bigMOTOR/prusa-remote-display/assets/images/display-social.png

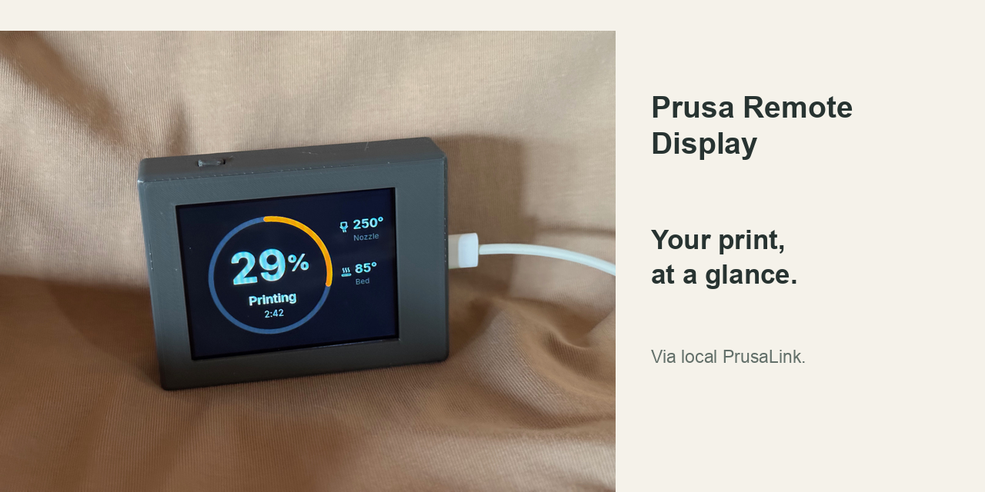
assets/images/display-social.png
