bigMOTOR/prusa-remote-display/enclosure/3mf/display-enclosure.3mf

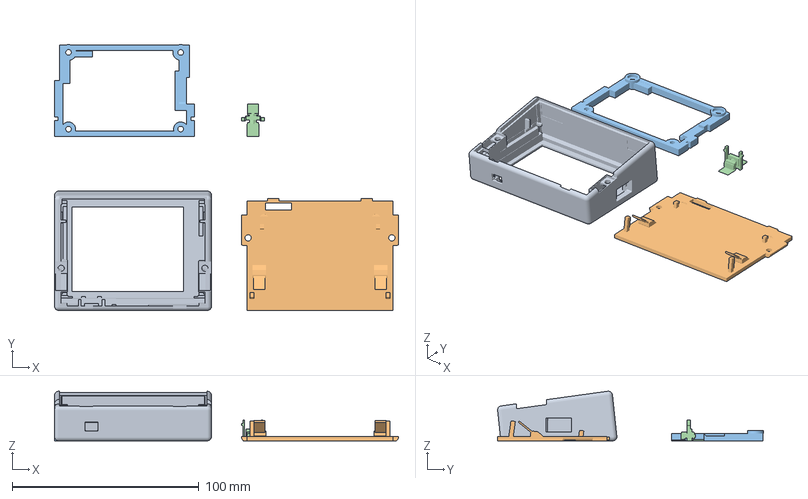
[picture p7: CAD file, 2026-11-03]
enclosure/3mf/display-enclosure.3mf
184.0 x 142.2 x 26.6 mm
