bigMOTOR/prusa-remote-display/enclosure/source/bases/button.step

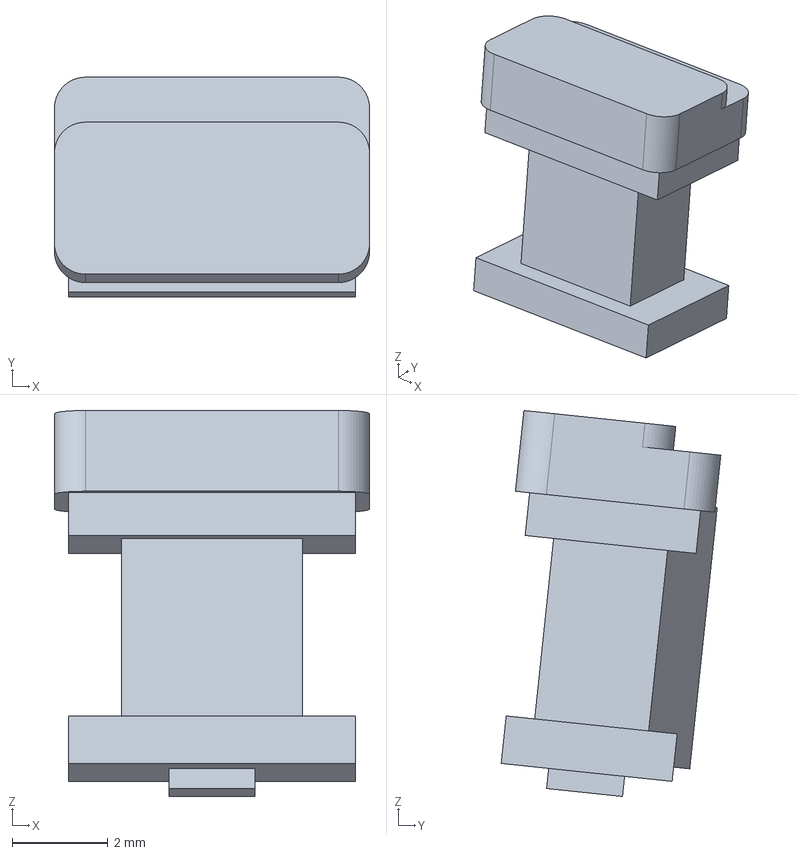
[picture p8: CAD file, 2026-11-03]
enclosure/source/bases/button.step
6.60 x 4.60 x 8.08 mm
