bigMOTOR/prusa-remote-display/enclosure/step/carrier.step

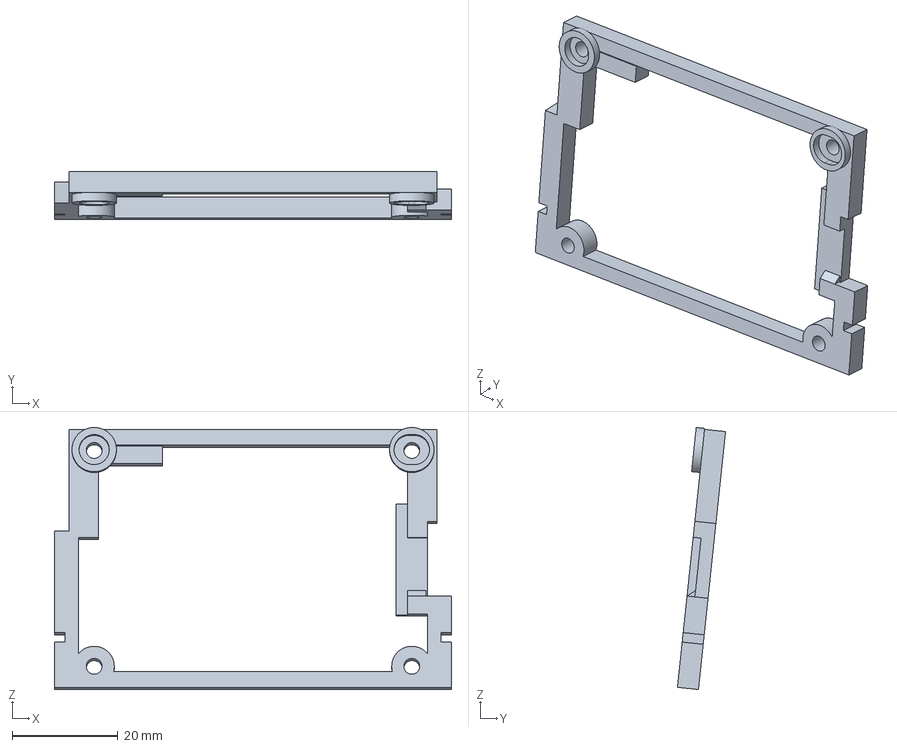
[picture p9: CAD file, 2026-11-03]
enclosure/step/carrier.step
75.0 x 9.10 x 49.5 mm
