bigMOTOR/prusa-remote-display/enclosure/source/bases/cassette.step

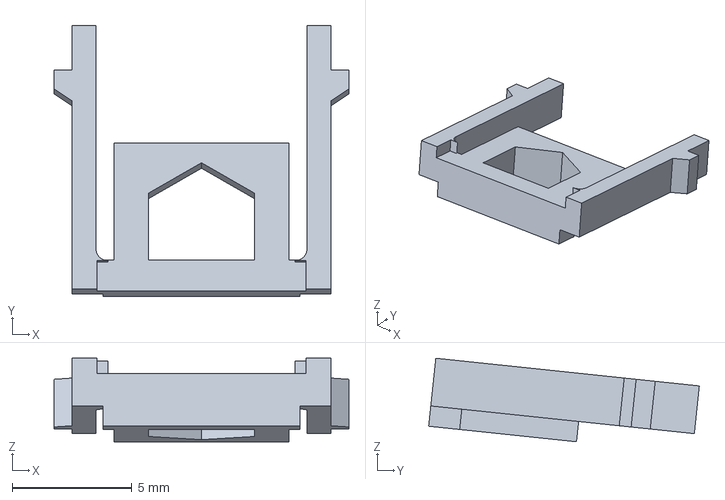
[picture p10: CAD file, 2026-11-03]
enclosure/source/bases/cassette.step
12.3 x 11.3 x 3.48 mm
