bigMOTOR/prusa-remote-display/enclosure/step/cassette.step

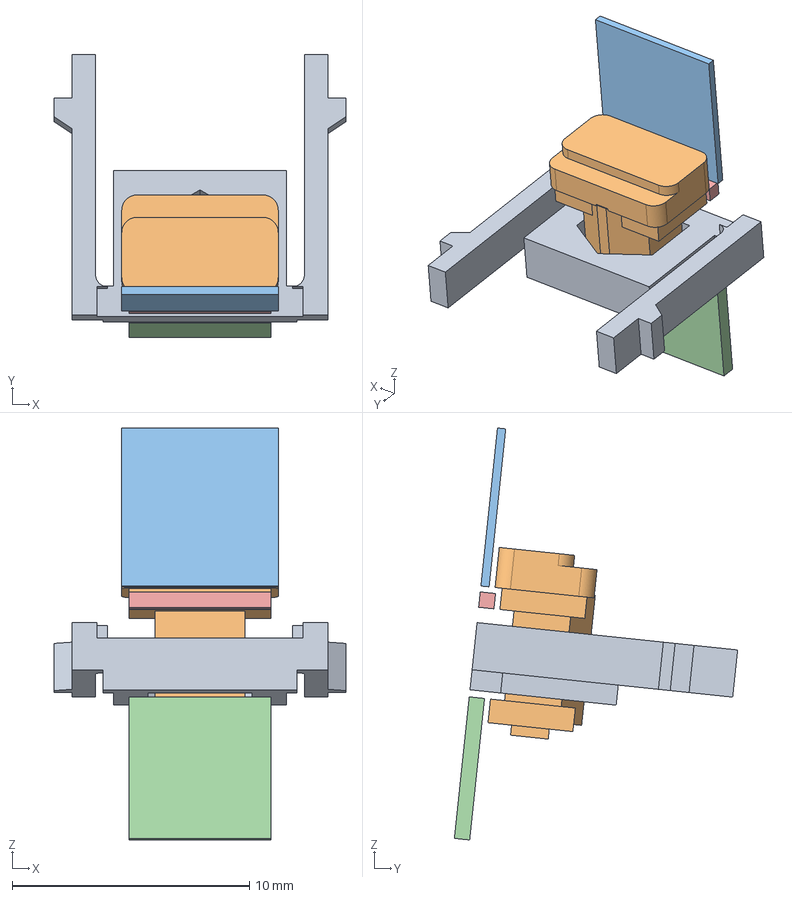
[picture p11: CAD file, 2026-11-03]
enclosure/step/cassette.step
12.3 x 11.9 x 17.4 mm
cassette
button-functional
TEMP-remove-cap-pad
TEMP-remove-lower-skirt-pad
TEMP-remove-upper-skirt-pad
