bigMOTOR/prusa-remote-display/enclosure/source/bases/shell.step

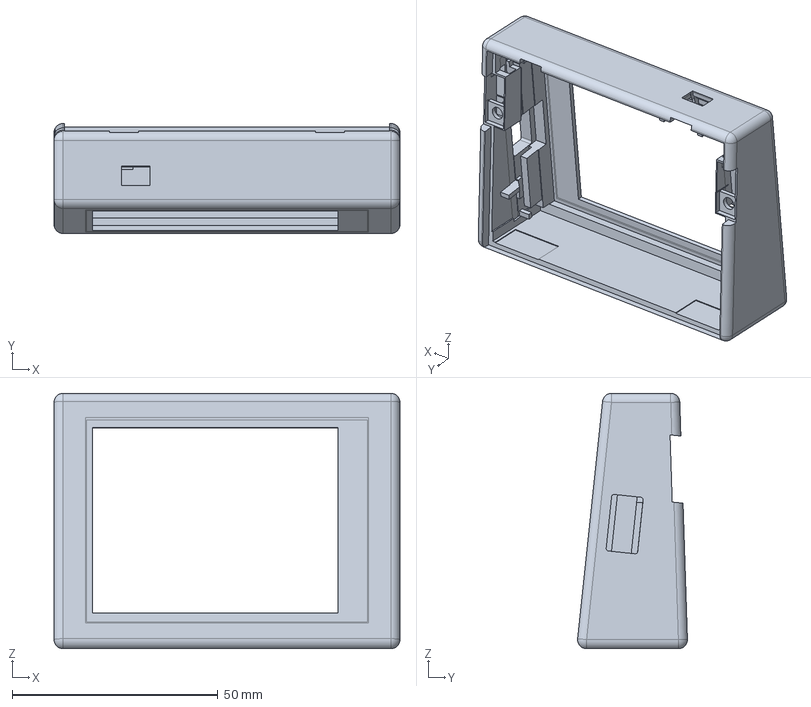
[picture p12: CAD file, 2026-11-03]
enclosure/source/bases/shell.step
84.0 x 26.7 x 62.0 mm
