bigMOTOR/prusa-remote-display/enclosure/source/bases/rear-cover.step

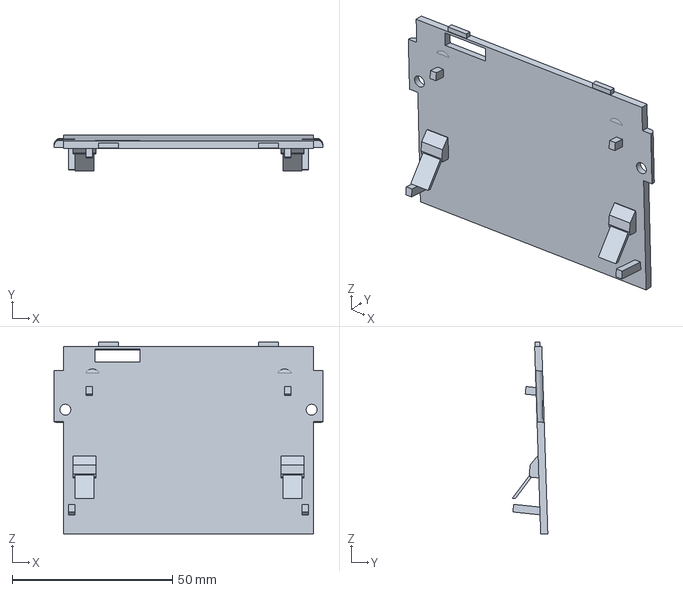
[picture p13: CAD file, 2026-11-03]
enclosure/source/bases/rear-cover.step
84.0 x 11.1 x 59.8 mm
