bigMOTOR/prusa-remote-display/(list of files, cad)

Other CAD files:
enclosure/step/shell.step
enclosure/step/rear-cover.step
enclosure/source/bases/carrier.step
enclosure/stl/carrier.stl
enclosure/stl/cassette.stl
enclosure/stl/rear-cover.stl
enclosure/stl/shell.stl
