bigMOTOR/prusa-remote-display/assets/images/printables-cover.png

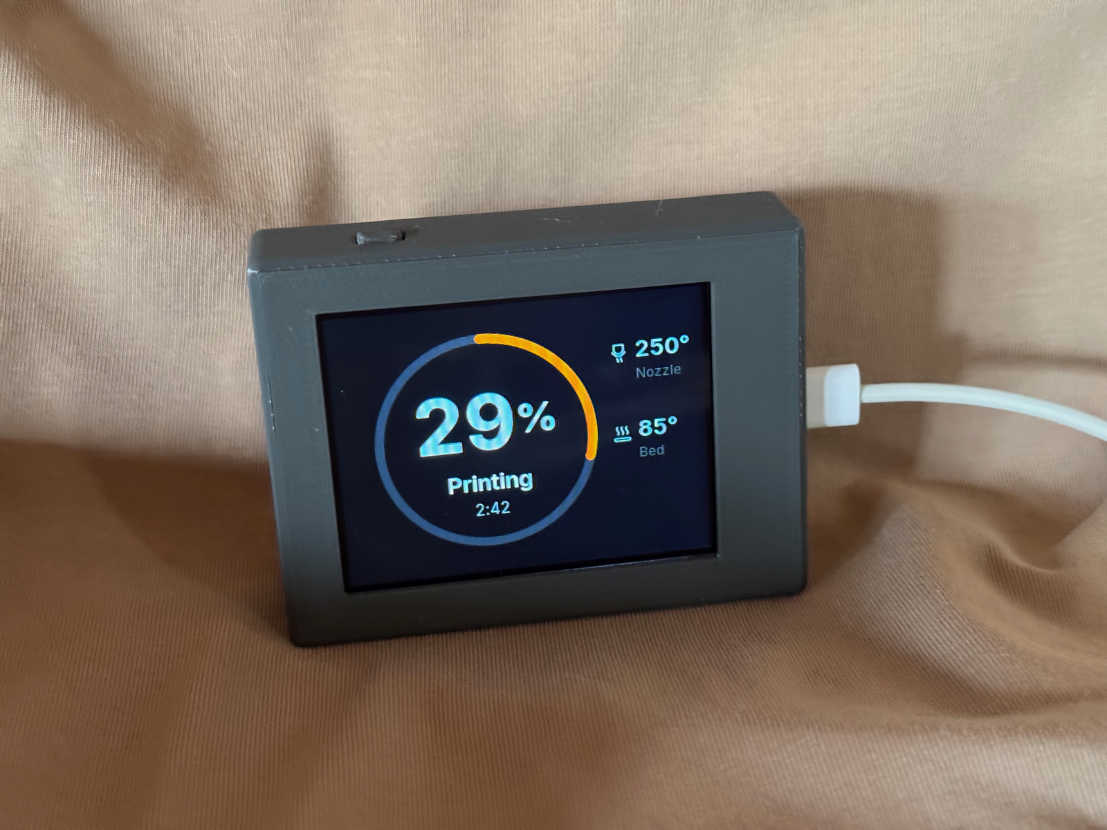
assets/images/printables-cover.png
