bigMOTOR/prusa-remote-display/firmware/components/validation/src/display_patterns_flow.cpp

// SPDX-FileCopyrightText: 2026 Mykola Fiantsev
// SPDX-License-Identifier: GPL-3.0-only

// sdkconfig.h first and explicitly — see the note in render_report_flow.cpp. A #if on
// an undefined CONFIG_* macro is silently false and turns this whole file into a stub.
#include "sdkconfig.h"

#include "panel_flows.hpp"

// Milestone 1 Phase C and D display bring-up, moved out of app_core unchanged.
//
// The behaviour here was signed off on the physical unit — panel initialisation,
// SPI clock sweep, the colour A/B comparison, the brightness curve and the PWM
// frequency sweep — so this file is a relocation, not a rewrite. Nothing about what
// it does to the display or the backlight has been altered.
//
// Mutually exclusive with the renderer, which is why nothing else needs to check.
// These flows write pixels straight to the panel, bypassing LVGL entirely, so app_core
// does not start ui when they are compiled in (display_patterns_compiled()). Until
// Milestone 2 Phase C that exclusion was against the Phase F bench scene; it is now
// against the product renderer, which always runs otherwise.

// TWO CONTRADICTIONS, MADE INTO BUILD FAILURES.
//
// Both were live in this repository at some point and neither produced any signal.
//
// The first: these flows and the LVGL diagnostic scene both initialise the panel, and
// only one may own it. Milestone 1 resolved that by run-time precedence, which meant
// the losing flow was compiled into the image and never ran.
//
// The second: the scenario flow exists to drive the product scene. With these patterns
// compiled in, app_core does not start the renderer, so there is no scene for the
// scenarios to drive — and a hardware-validation image built that way validates nothing
// it was built to validate. That combination shipped in the profile for one build during
// Milestone 2 Phase C and was caught only by comparing the measured image size against
// the committed figure. This is what makes it impossible rather than merely documented.
#if defined(CONFIG_PRD_DISPLAY_TEST_PATTERNS) && defined(CONFIG_PRD_UI_DIAGNOSTIC_SCENE)
#error "PRD_DISPLAY_TEST_PATTERNS and PRD_UI_DIAGNOSTIC_SCENE both own the panel; select one"
#endif

#if defined(CONFIG_PRD_DISPLAY_TEST_PATTERNS) && defined(CONFIG_PRD_VALIDATION_SCENARIOS)
#error                                                                                             \
    "PRD_DISPLAY_TEST_PATTERNS stops the product renderer starting, so PRD_VALIDATION_SCENARIOS would have no scene to drive; select one"
#endif

#if defined(CONFIG_PRD_DISPLAY_TEST_PATTERNS)

#include <cstdint>
#include <string>

// ESP-IDF headers are not -Wundef clean. Suppressed for this TU in CMakeLists.txt
// per architecture spec §12.3, as for every other ESP-IDF adapter boundary.
#include "freertos/FreeRTOS.h"
#include "freertos/task.h"

#include "diagnostics/log.hpp"
#include "diagnostics/tags.hpp"
#include "diagnostics/task_report.hpp"
#include "display/display.hpp"
#include "display/panel_tuning.hpp"
#include "display/test_patterns.hpp"

namespace prd::validation::internal {
namespace {

// Advances patterns on a timer so the panel can be inspected without any input
// component existing. Phase C predates the button.
constexpr TickType_t kPatternInterval = pdMS_TO_TICKS(6000);
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
