bigMOTOR/prusa-remote-display/(commit log)

2026-11-03 Initial v1.0.0 source snapshot
    [button.step, carrier.step, carrier.stl, cassette.step, cassette.stl, display-enclosure.3mf, partitions.csv, rear-cover.step]
2026-11-03 docs: add published Printables case link (#2)
2026-11-05 docs: clarify tested display board compatibility
2026-11-05 docs: clarify reference board marking (#6)
2026-11-06 Fix GitHub OTA request buffer for 1.1.1
    [public_https.cpp, public_https_limits.hpp]
